ciborg971/SPW/Kicad/Kicad.kicad_sch

## KiCad design Kicad/Kicad.kicad_sch (2024-08-09)

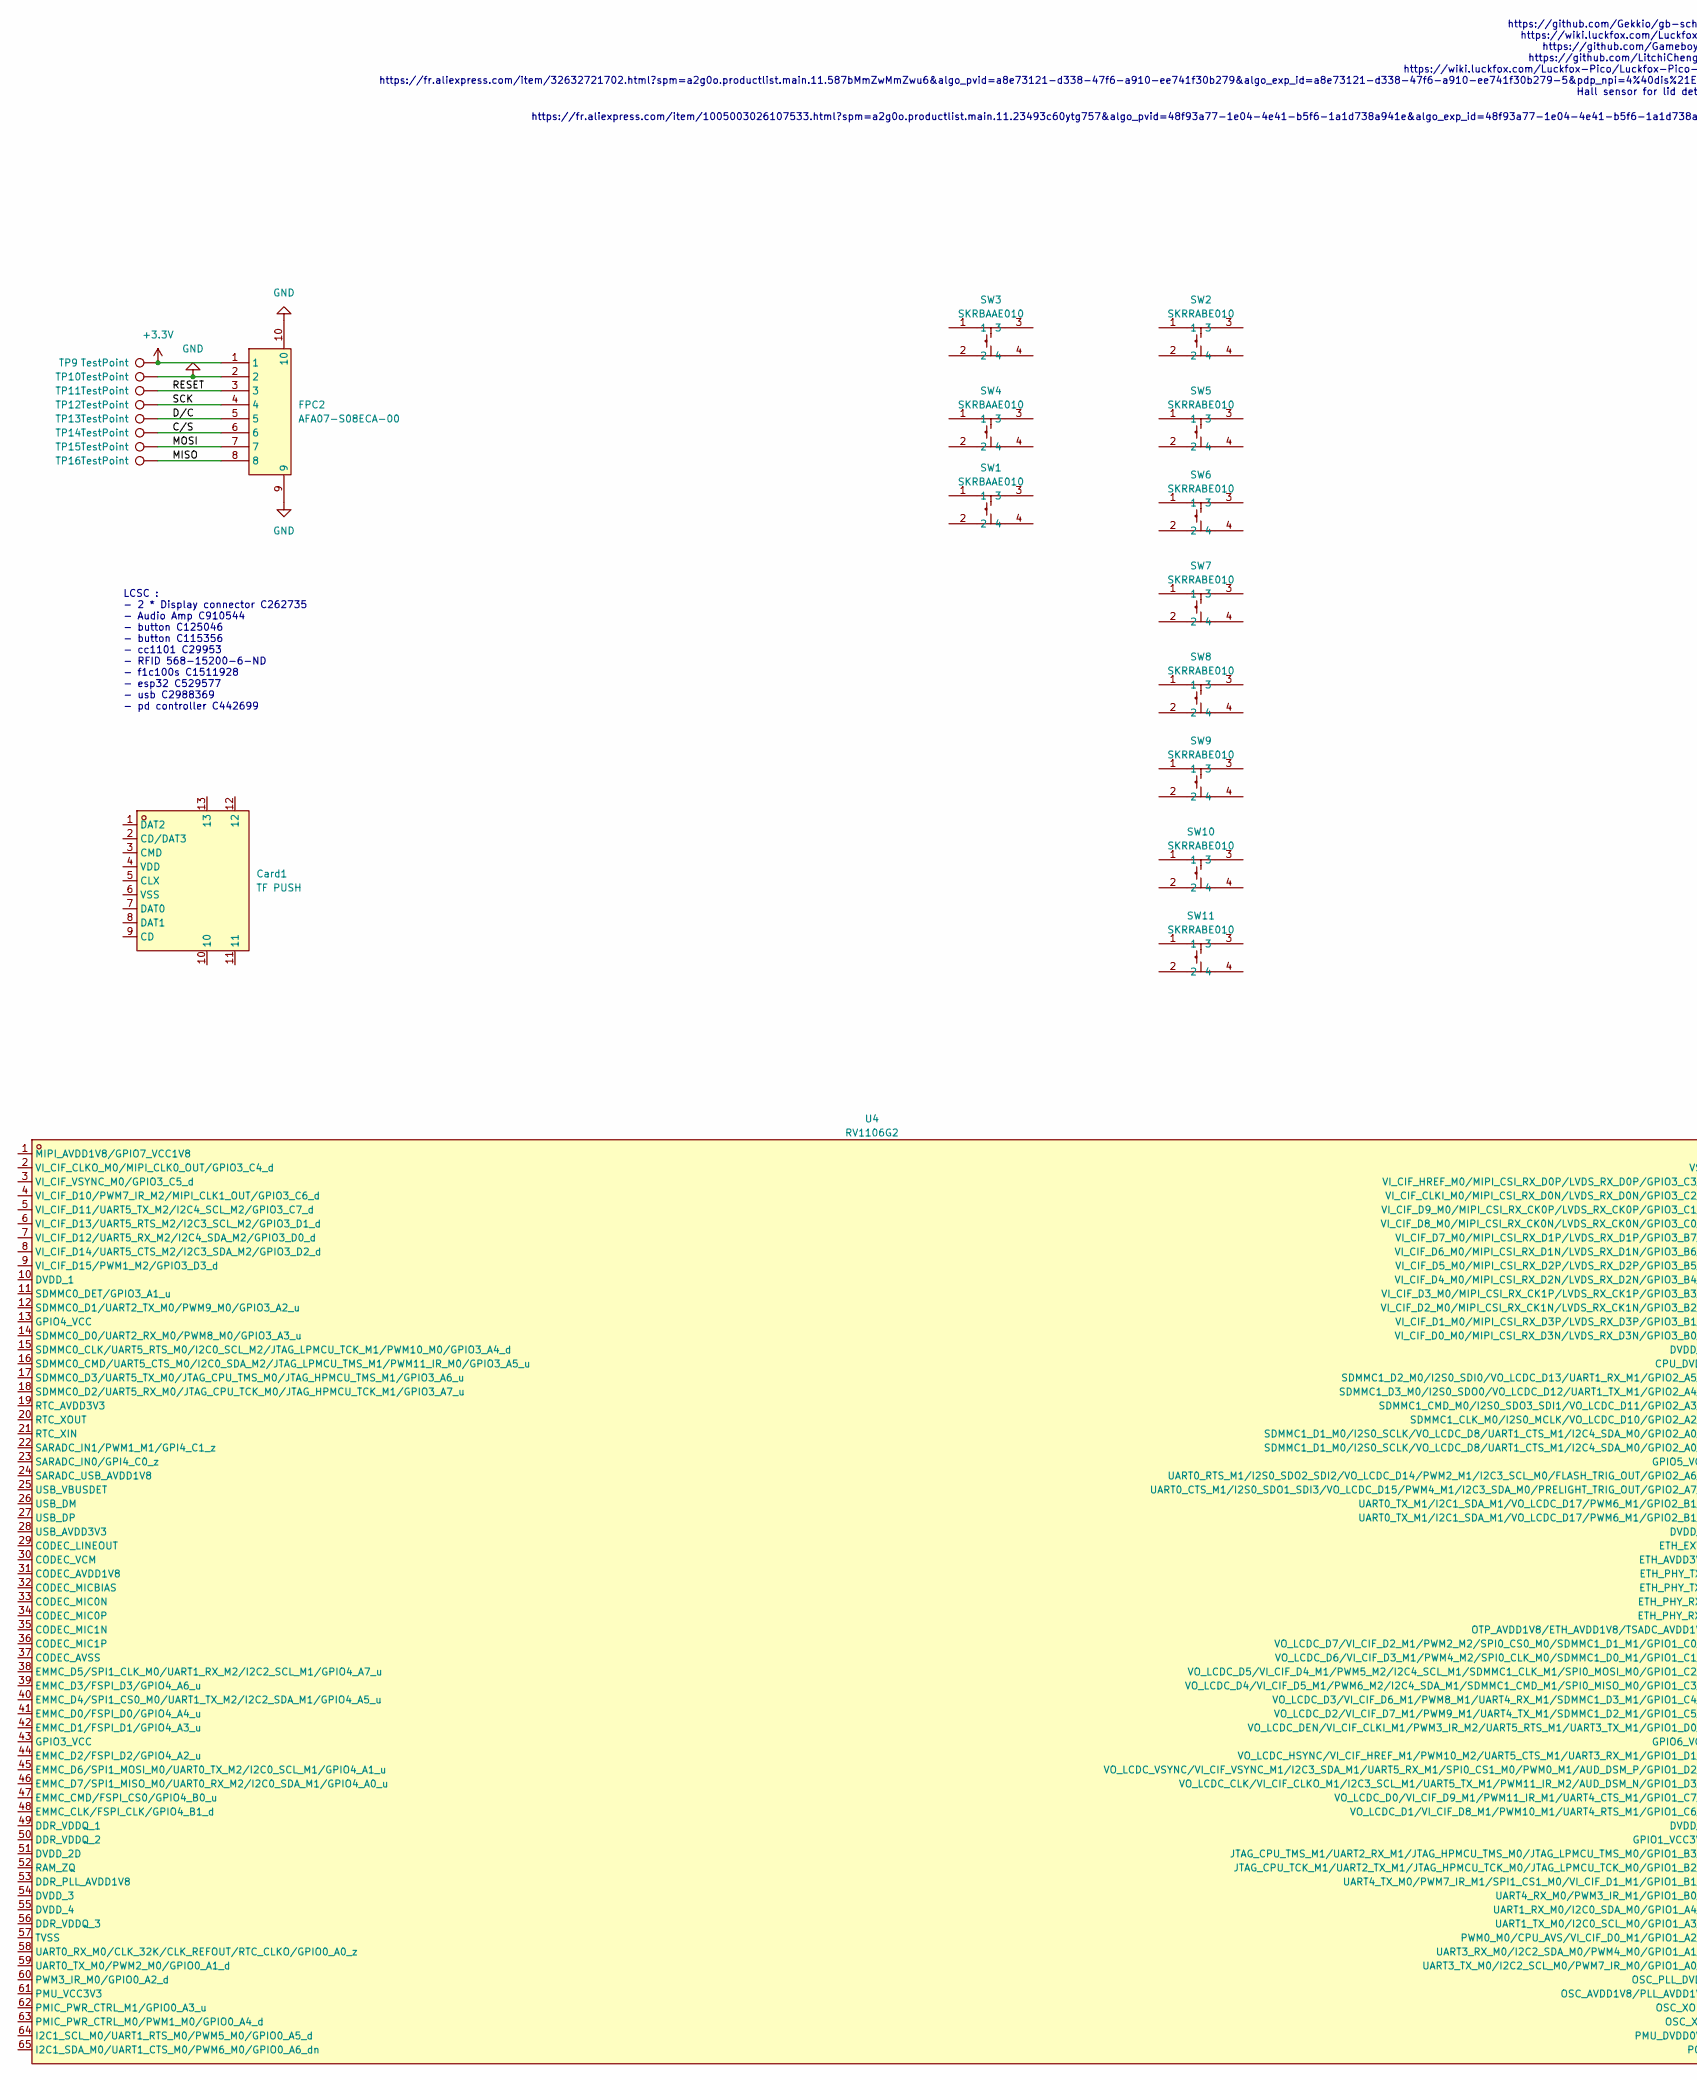
[picture p1: schematic Kicad.kicad_sch, part in row 1, column 1]

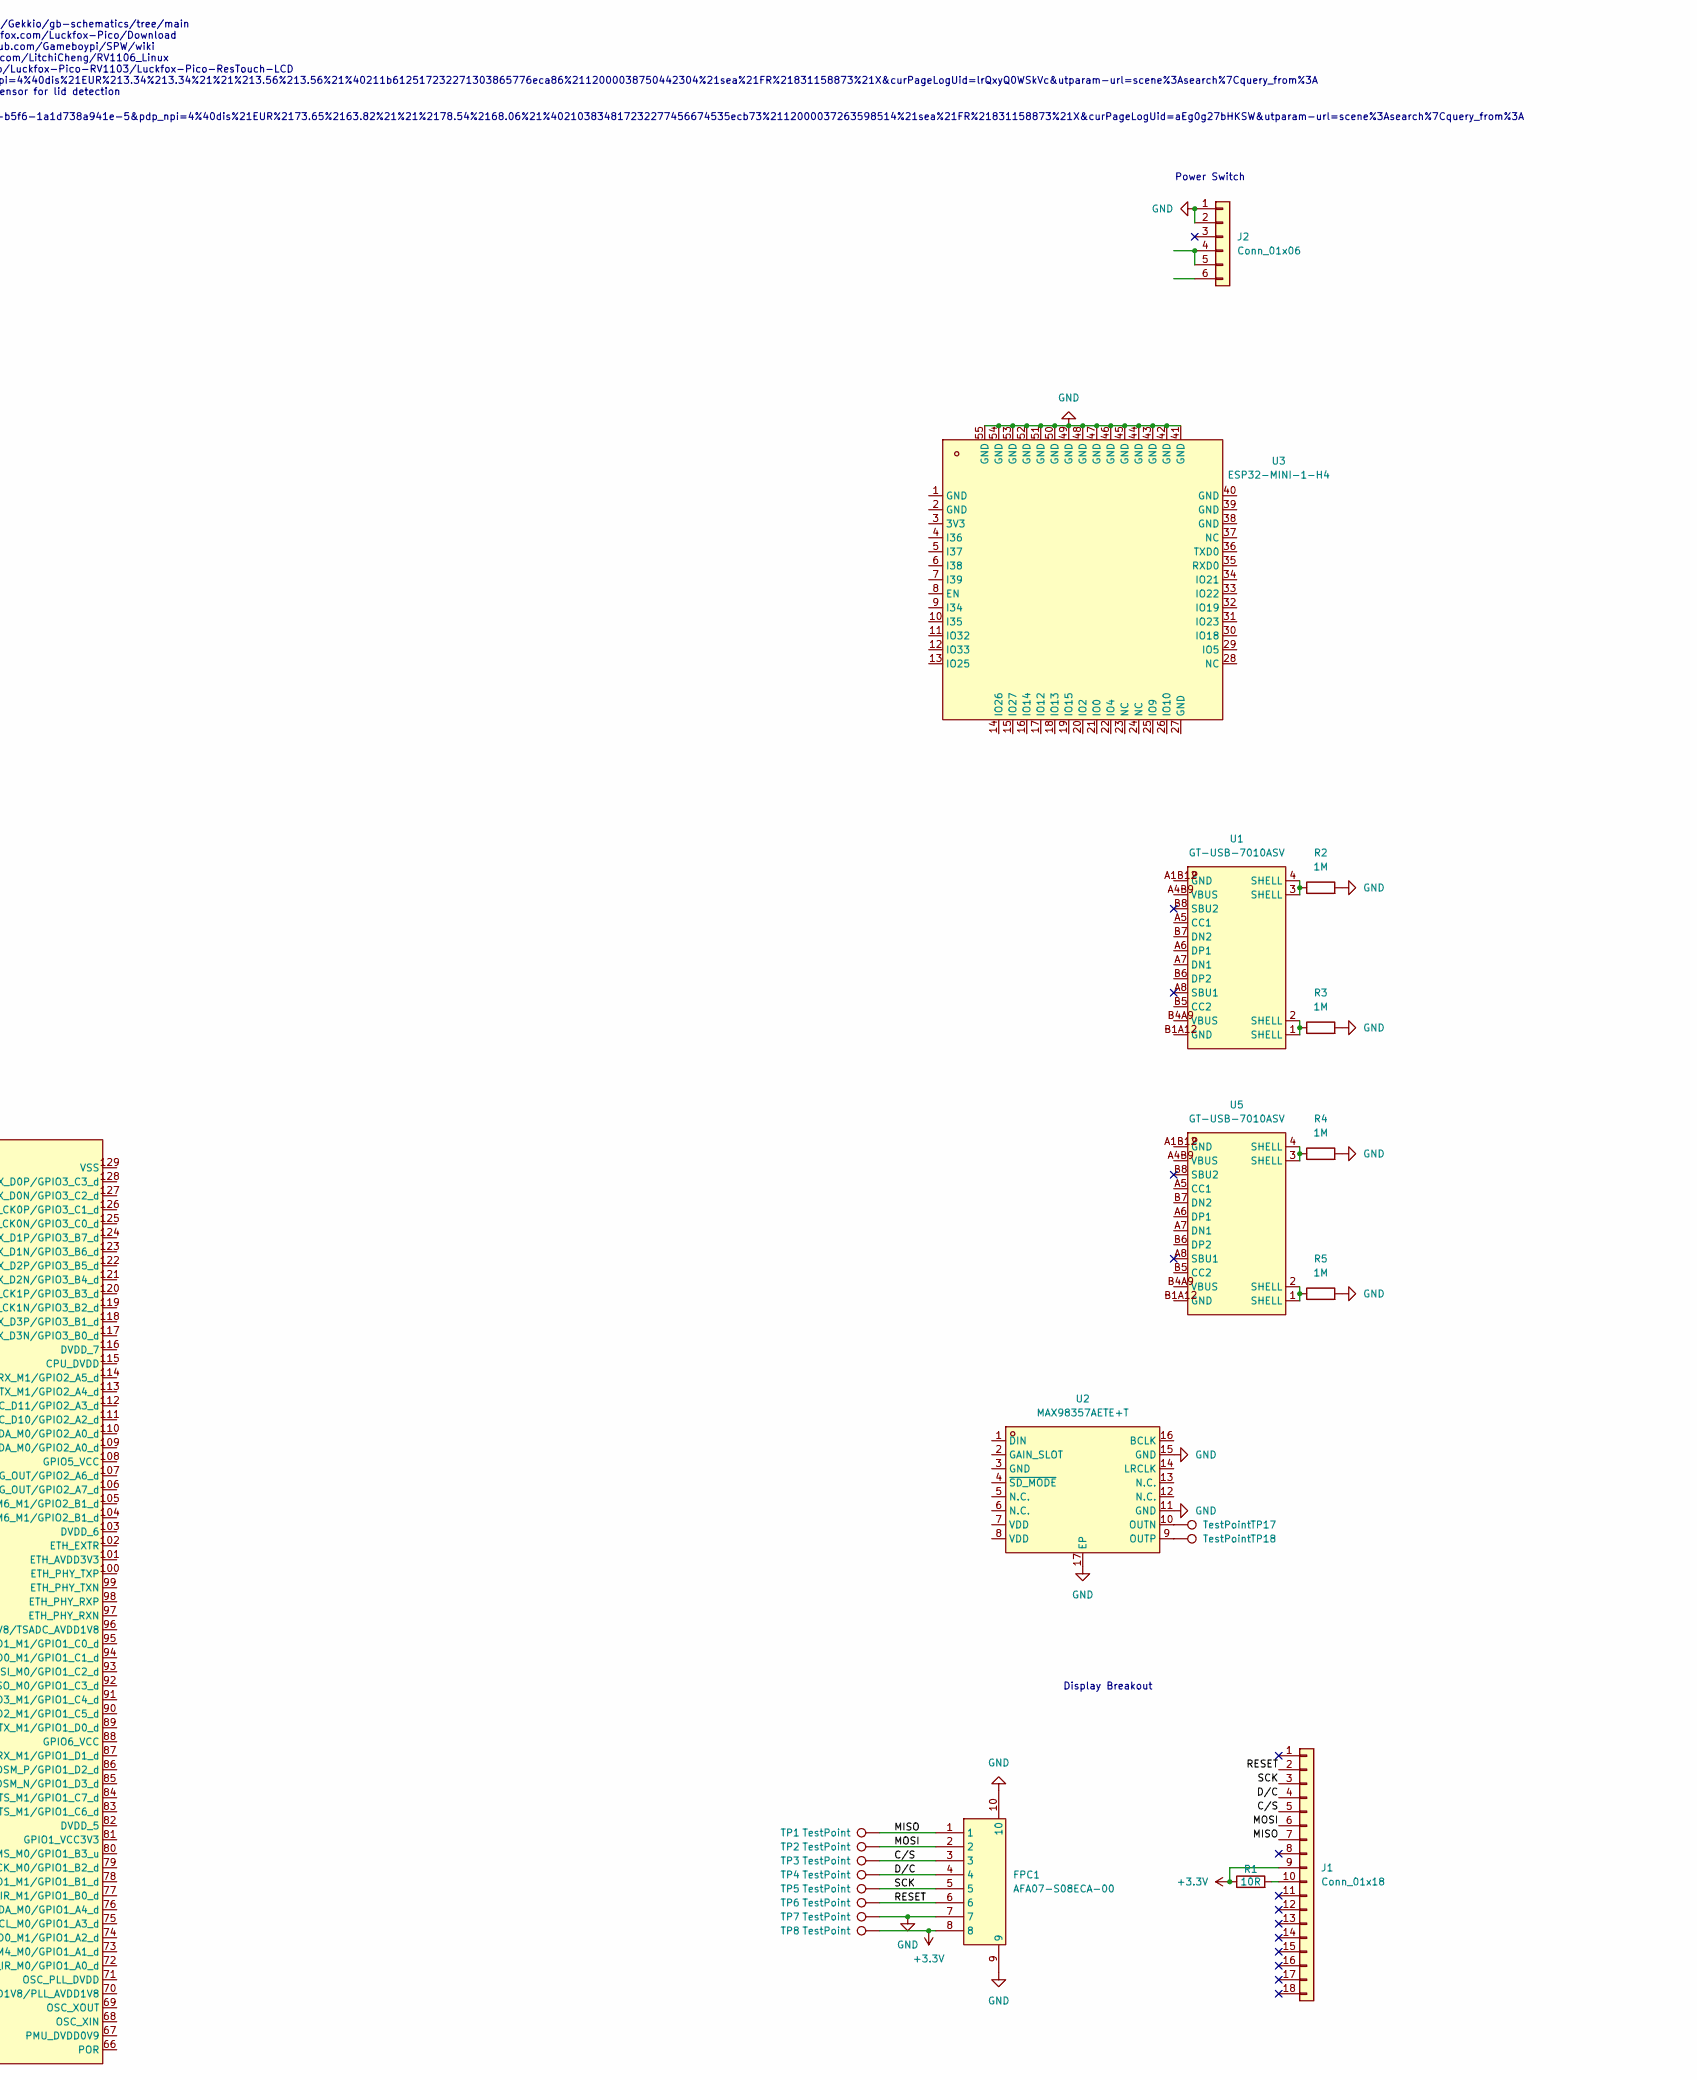
[picture p2: schematic Kicad.kicad_sch, part in row 1, column 2]

Parts:
Card1: TF PUSH; TF-SMD_TF-PUSH; LCSC Part C393941
FPC1, FPC2: AFA07-S08ECA-00; FPC-SMD_P1.00-8P_LCS-SJ-H2.5; LCSC Part C262735
J1: Conn_01x18; Display18PIN
J2: Conn_01x06; Switch
R1: 10R; R_0805_2012Metric
R2, R3, R4, R5: 1M
SW1, SW3, SW4: SKRBAAE010; KEY-SMD_4P-L4.8-W4.8-P3.65_SKRBAAE010; LCSC Part C115356
SW2, SW5, SW6, SW7, SW8, SW9, SW10, SW11: SKRRABE010; KEY-SMD_4P-L7.5-W7.0-P6.00-LS5.0; LCSC Part C125046
TP1, TP2, TP3, TP4, TP5, TP6, TP7, TP8, TP9, TP10, TP11, TP12, TP13, TP14, TP15, TP16: TestPoint; TestPoint_Pad_D1.5mm
TP17, TP18: TestPoint; TestPoint_Pad_2.5x2.5mm
U1, U5: GT-USB-7010ASV; USB-C-SMD_G-SWITCH_GT-USB-7010ASV; LCSC Part C2988369
U2: MAX98357AETE+T; TQFN-16_L3.0-W3.0-P0.50-BL-EP1.5; LCSC Part C910544
U3: ESP32-MINI-1-H4; WIFI-SMD_ESP32-MINI-1; LCSC Part C3013933
U4: RV1106G2; QFN-128_L12.3-W12.3-P0.35-TL-EP7.0-1; LCSC Part C5272606

Connections:
+3.3V: FPC1.8, FPC2.1, J1.9, R1.1, TP8.1, TP9.1
C/S: FPC1.3, FPC2.6, J1.5, TP3.1, TP14.1
D/C: FPC1.4, FPC2.5, J1.4, TP4.1, TP13.1
GND: FPC1.7, FPC1.9, FPC1.10, FPC2.2, FPC2.9, FPC2.10, J2.1, J2.2, R2.2, R3.2, R4.2, R5.2, TP7.1, TP10.1, U2.11 (GND), U2.15 (GND), U2.17 (EP), U3.41 (GND), U3.42 (GND), U3.43 (GND), U3.44 (GND), U3.45 (GND), U3.46 (GND), U3.47 (GND), U3.48 (GND), U3.49 (GND), U3.50 (GND), U3.51 (GND), U3.52 (GND), U3.53 (GND), U3.54 (GND), U3.55 (GND)
MISO: FPC1.1, FPC2.8, J1.7, TP1.1, TP16.1
MOSI: FPC1.2, FPC2.7, J1.6, TP2.1, TP15.1
unnamed: J1.10, R1.2
unnamed: J2.4, J2.5
unnamed: R2.1, U1.3 (SHELL), U1.4 (SHELL)
unnamed: R3.1, U1.1 (SHELL), U1.2 (SHELL)
unnamed: R4.1, U5.3 (SHELL), U5.4 (SHELL)
unnamed: R5.1, U5.1 (SHELL), U5.2 (SHELL)
unnamed: TP17.1, U2.10 (OUTN)
unnamed: TP18.1, U2.9 (OUTP)
RESET: FPC1.6, FPC2.3, J1.2, TP6.1, TP11.1
SCK: FPC1.5, FPC2.4, J1.3, TP5.1, TP12.1

Notes on the sheet:
https://github.com/Gekkio/gb-schematics/tree/main https://wiki.luckfox.com/Luckfox-Pico/Download https://github.com/Gameboypi/SPW/wiki https://github.com/LitchiCheng/RV1106_Linux https://wiki.luckfox.com/Luckfox-Pico/Luckfox-Pico-RV1103/Luckfox-Pico-ResTouch-LCD https://fr.aliexpress.com/item/32632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
LCSC : - 2 * Display connector C262735 - Audio Amp C910544 - button C125046 - button C115356 - cc1101 C29953 - RFID 568-15200-6-ND - f1c100s C1511928 - esp32 C529577 - usb C2988369 - pd controller C442699
Power Switch
Display Breakout
https://fr.aliexpress.com/item/1005003026107533.html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…
