ciborg971/SPW/(commit log)

2024-01-07 New Kicad project + cleaning pcb + doc
    [Kicad.kicad_sch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]
2024-08-09 add esp32, rv1106, audio chip, buttons, usb and a bunch of cleaning
    [Kicad.kicad_sch]
2024-08-09 add rv1106 doc, more cleaning
    [Kicad.kicad_sch]
